epccs/Irrigate7/Uart/README.md

# AVR  Interrupt-Driven UART with stdio redirect

## Overview

Uart is an interactive command line program that demonstrates stdio redirect of a minimalized interrupt-driven UART core. 

Referance ATmega1284p datasheet USART Universal Synchronous and Asynchronous serial Receiver and Transmitter.

## Firmware Upload

With a serial port connection (see BOOTLOAD_PORT in Makefile) and xboot installed on the Irrigate7 run 'make bootload' and it should compile and then flash the MCU.

```
sudo apt-get install git gcc-avr binutils-avr gdb-avr avr-libc avrdude
git clone https://github.com/epccs/Irrigate7/
cd /Irrigate7/Uart
make bootload
...
avrdude done.  Thank you.
``` 

Now connect with picocom (or ilk). Note I am often at another computer doing this through SSH. The Samba folder is for editing the files from Windows.

``` 
#exit is C-a, C-x
picocom -b 38400 /dev/ttyUSB0
``` 

# Commands

Commands are interactive over the serial interface at 38400 baud rate. The echo will start after the second character of a new line. 

## /0/id? [name|desc|avr-gcc]

identify 

``` 
/0/id?
{"id":{"name":"Uart","desc":"Irrigate7 (14320^5) Board /w atmega1284p","avr-gcc":"5.4.0"}}
```
