epccs/Irrigate7/AmpHr/README.md

# Amp-Hour Counter

## Overview

Use ADC reading to Accumulate at timed intervals from a sense resistor. This is an interactive command line program that demonstrates how the ATmega1284p can be used to track the discharge from a battery. 

[Adc]: ../Adc

# Firmware Upload

With a serial port connection (set the BOOTLOAD_PORT in Makefile) and xboot installed on the Irrigate7 run 'make bootload' and it should compile and then flash the MCU.

``` 
sudo apt-get install git gcc-avr binutils-avr gdb-avr avr-libc avrdude
git clone https://github.com/epccs/Irrigate7/
cd /Irrigate7/AmpHr
make bootload
...
avrdude done.  Thank you.
``` 

Now connect with picocom (or ilk). 

``` 
#exit is C-a, C-x
picocom -b 38400 /dev/ttyUSB0
``` 

or log the terminal session

``` 
script -f -c "picocom -b 38400 /dev/ttyUSB0" stuff.json
``` 

# Commands

Commands are interactive over the serial interface at 38400 baud rate. The echo will start after the second character of a new line. 

## /\[rpu_address\]/[command \[arg\]\]

rpu_address is taken from the I2C address 0x29 (e.g. get_Rpu_address() which is included form ../Uart/id.h). The value of rpu_address is used as a character in a string, which means don't use a null value (C strings are null terminated), but the ASCII value for '1' (0x31) is easy and looks nice, though I fear it will cause some confusion when it is discovered that the actual address value is 49.

Commands and their arguments follow.

## /0/id? \[name|desc|avr-gcc\]

identify 

``` 
/1/id?
{"id":{"name":"AmpHr","desc":"Irrigate7 (14320^5) Board /w atmega1284p","avr-gcc":"5.4.0"}}
```

##  /0/charge?

Report the discharge since the day-night state machine cleared the accumulation.

``` 
/1/charge?
{"CHRG_mAHr":"0.14","ACCUM_Sec":"27.40"}
/1/analog? 6,7
{"PWR_I":"0.017","PWR_V":"12.74"}
```

## [/0/analog? 0..7\[,0..7\[,0..7\[,0..7\[,0..7\]\]\]\]](../Adc#0analog-0707070707)

## [/0/pwm CH1..CH6,0..255](../Pwm#0pwm-ch1ch60255)

## [/0/pMod 14..16,INPUT|OUTPUT](../Digital#0pmod-1416inputoutput)

## [/0/dWrt 14..16,HIGH|LOW](../Digital#0dwrt-1416highlow)

## [/0/dTog 14..16](../Digital#0dtog-1416)

## [/0/dRe? 14..16](../Digital#0dre-1416)

## [/0/showstat ON|OFF](../Digital#0showstat-onoff)

## [/0/iscan?](../i2c-debug#0iscan)

## [/0/iaddr 0..127](../i2c-debug#0iaddr-0127)

## [/0/ibuff 0..255\[,0..255\[,0..255\[,0..255\[,0..255\]\]\]\]](../i2c-debug#0ibuff-02550255025502550255)

## [/0/ibuff?](../i2c-debug#0ibuff)

## [/0/iwrite](../i2c-debug#0iwrite)

## [/0/cs 0..3,ON|OFF](../CurrSour#0cs-01onoff)

## [/0/csp 0..0,ON|OFF](../CurrSour#0csp-00onoff)
