epccs/Irrigate7/Hardware/Design/14320BRD,BOM.csv

LINE | REF | QTY | EPCCS TYP | EPCCS PN | MFG@PN | DESCRIPTION | NOTES | COST EA | LINE COST | BIN
 |  |  |  |  |  | Irrigate7 Board |  |  | TOTAL
 |  |  |  |  |  | 9/2/18 (14320^5) |  |  | =SUM(J5:J100)
1 |  | =1/3 | BOARD | OSHPARK |  | PCB 2 LAYER ENIG 3 COPY | () | 56.70 | =C5*I5 | IRRIGATE7
 |  |  |  |  |  | NOTES
