epccs/Irrigate7/Hardware/Design/14320DIN,BOM.csv

LINE | REF | QTY | EPCCS TYP | EPCCS PN | MFG@PN | DESCRIPTION | NOTES | COST EA | LINE COST | BIN
 |  |  |  |  |  | Irrigate7 DIN |  |  | TOTAL
 |  |  |  |  |  | 9/2/18 (14320^5) |  |  | =SUM(J5:J100)
1 | HW1 HW2 | 2 | HW-DINMNT | USA10-4.6 | PHXCONT@1201578 | DINRAIL ADAPTER UNIVERSAL 10MM 2.75MM | (1) | 1.13 | =C5*I5 | SHLD
2 |  | 4 | HW-SCREW | ZN6PSMS38 | B&F@PSMS 006 0038 PH | PAN SHT MTL SCREW #6 PHP .38L ZN | (1) | 0.1022 | =C6*I6 | SHLD
 |  |  |  |  |  | NOTES
 |  |  |  |  |  | (1) Alternate part with same or better rating allowed
