epccs/Irrigate7/Hardware/Evaluation/readme.md

# Description

This shows the setup and method used for evaluation of Irrigate7.

# Table of References

# Table Of Contents:

0. ^5 Replace RPUno^9 in Garden
0. ^5 Port Software from RPUno^9
0. ^3 CL8 Interface
0. ^2 Crystal Check
0. ^2 RS422 Shield
0. ^2 Lifting DIN Mount
0. ^1 Sensor Loop Select
0. ^1 CCtest
0. ^1 With RPUftdi^2
0. ^0A LT3652 Timer

## ^5 Replace RPUno^9 in Garden

The old setup had a K3 board and an RPUno.

RPUno^9+3Valves RPUno^9 and 3 Valves

Replaced with Irrigate7 which has four unused drivers in this setup. K1 moved to K7, K2 moved to K6, and K3 moved to K5.

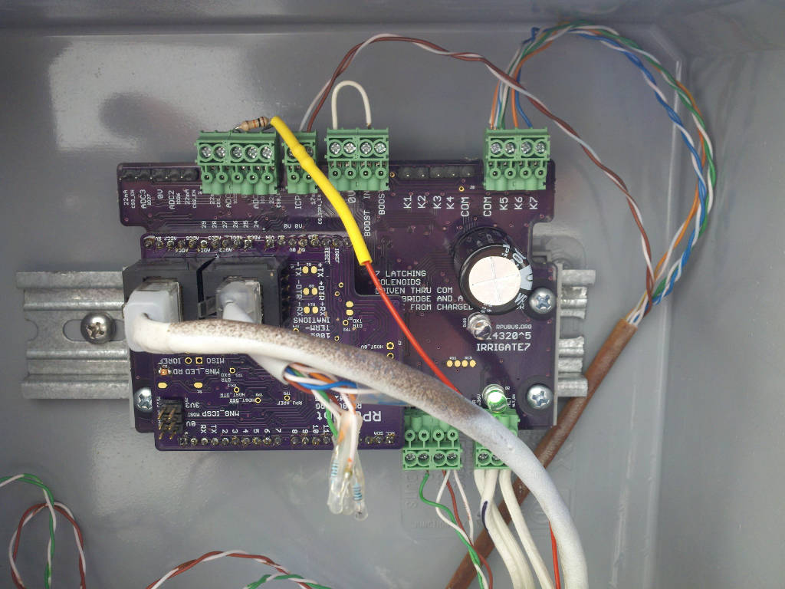
[picture p25: Hardware/Evaluation/Irrigate7^5+RPUadpt^5_w3ValvesPvBat.jpg]
Irrigate7^5 RPUadpt^5 and Valves


The valves have been operated for about two years with previous versions of K3 and RPUno, they were set and reset ten times each day so that is over 3500 operations each. The coil resistance is about 4.7 Ohm and they are driven through a CAT5 pair that is less than 4 meters (e.g. 0.19*4 Ohm). They are operating with a pulse voltage of 24VDC from a 2200uF capacitor, so the peak current has been near 3.75A, that is higher than I would like but has been working.

The [Irrigate7^5_log] will be updated as testing continues.

[Irrigate7^5_log]: Irrigate7^5_log.txt

## ^5 Port Software from RPUno^9

On Irrigate7^5 the LT3652, CL8 interface, ICP3, and Sensor Loop's were removed. Basically, it is now an RPUno with an extended K3 (to K7) on board. When swapping an RPUno^9+K3 for the Irrigate7^5  the wiring is a lot easier, but a few changes are present. The KNL software now fits (uses about 27%) with every command available, so I have room to extend. The ported software needs more testing but there is less that can go wrong now that much of the design is the same. 

SPI pins are now dedicated to that bus, ICP3 was on the MOSI pin. The RPUadpt^6 and hopefully the RPUpi^4 should allow options like SD cards and an SBC to do DAQ at higher rates. 

I am looking at doing an I2C board with a PCA6985 used to control 16 channels of 22mA current sources. They could be used to drive capacitive sensors (and a range of other things). I think they could feed one at a time into the ICP1 input when its current source is disabled to capture the capacitive sensor oscillator timing. This would need to be initiated by the SBC since it will need to figure out what to do with the data anyway.

## ^3 CL8 Interface

The IDE connector just fits, though there is interference with the shield. I can make the board larger but that will cost more, I think this will do.

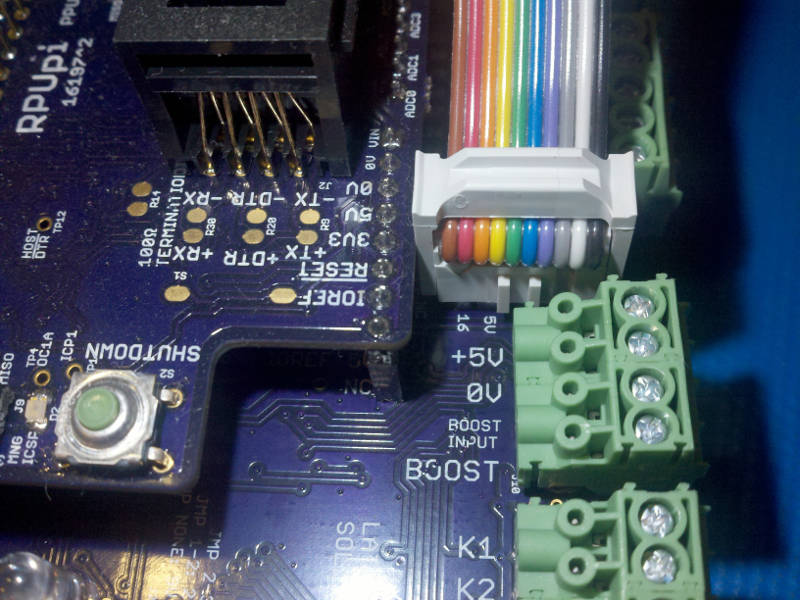
[picture p26: Hardware/Evaluation/Irrigat7^3,WithCL8Interface.jpg]
Irrigate7^3 CL8 Interface


## ^2 Crystal Check

The crystal has 27pF crystal capacitors which combine with the board's parasitic capacitance to make the crystals load capacitance.

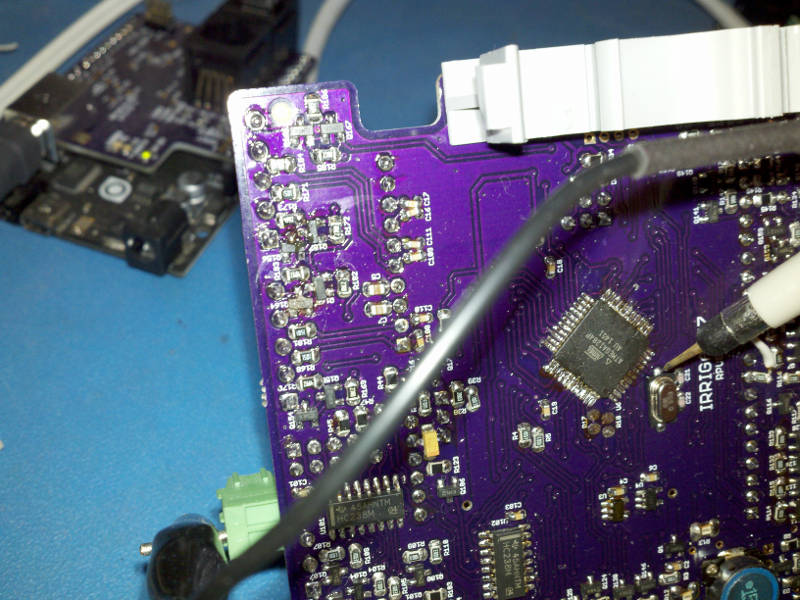
[picture p27: Hardware/Evaluation/Irrigat7^2,CrystalCheck.jpg]
Irrigate7^2 Crystal Check

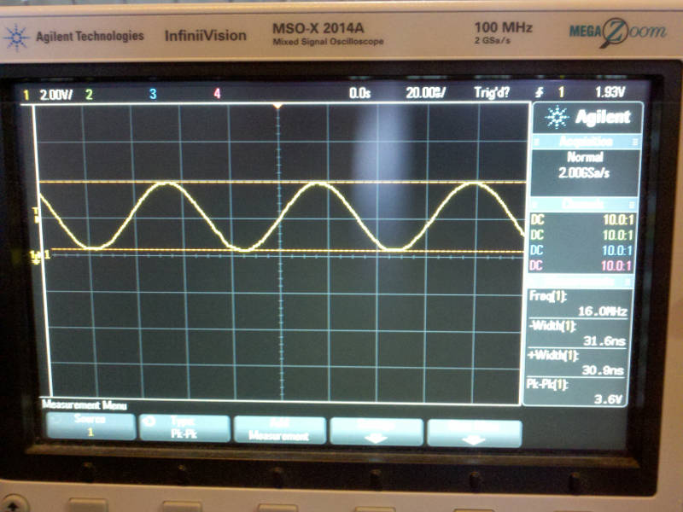
[picture p28: Hardware/Evaluation/Irrigat7^2,CrystalCheckOnDSO.jpg]
Irrigate7^2 Crystal Check On DSO


Previous versions had a different crystal that needed less capacitance (which unfortunately got copied onto other boards).

## ^2 RS422 Shield

RPUpi and RPUadpt are RS422 shields that connect to controller boards serial (RX/TX) lines. The RPUpi crosses over the host computer (Pi Zero) serial lines to the RS422. As a result, the host can talk to both the ATmega1284p on Irrigate7 and the ATmega328p on RPUno through the multidrop interface. The microcontrollers are programmed with the GNU GCC toolchain for AVR which is available on Raspiban (an OS that runs on the Pi Zero). The toolchain can build firmware (projects) for both the RPUno and Irrigate7. 

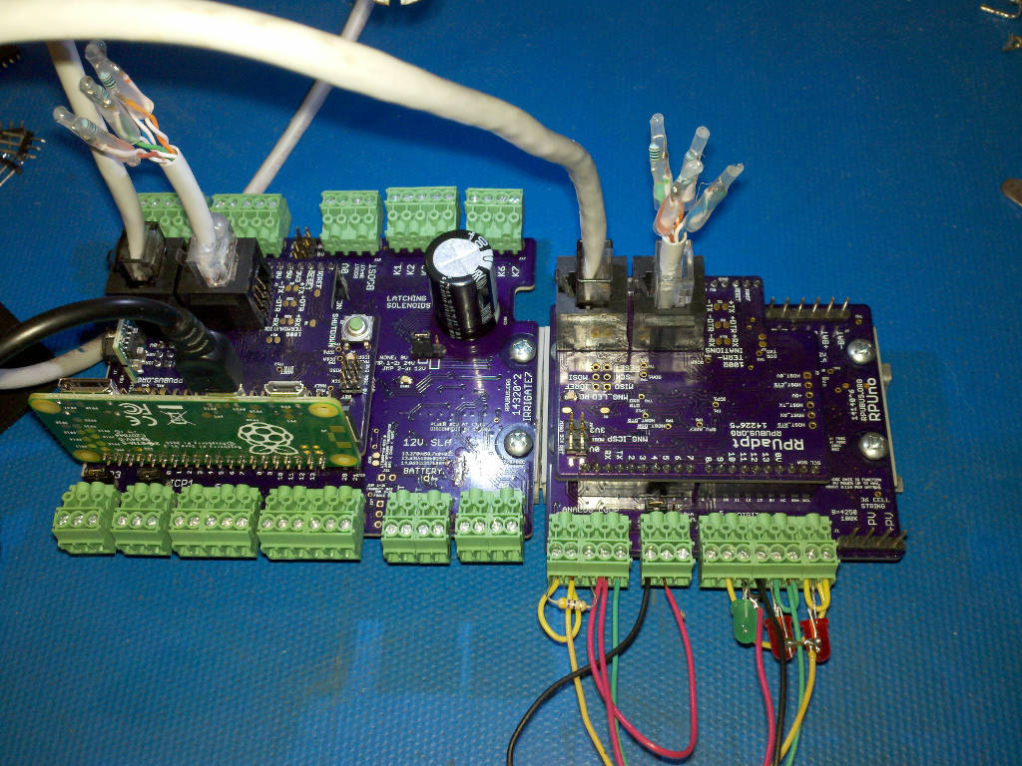
[picture p29: Hardware/Evaluation/Irrigat7^2,WithRPUpi^2_RS422to_RPUno^6_RPUadpt^5.jpg]
Irrigate7^2 RS422


## ^2 Lifting DIN Mount

A flat blade screwdriver is used to lift the DIN mount away from the rail, which is how almost all DIN systems work (though sometimes it is not this obvious).

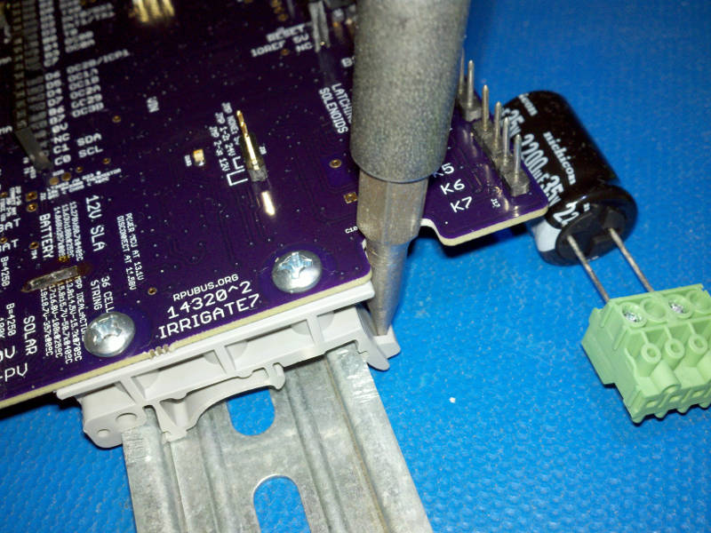
[picture p30: Hardware/Evaluation/14320^2,LiftingDinMount.jpg]
Irrigate7^2 Lift DIN Mount


## ^1 Sensor Loop Select

Using an [HT]^1 and [LoopPwr] firmware. The image shows a connection of the HT on LS2 and an LED on LS0. LS2 has ben selected and enabled with the firmware, and ICP1 is receving an inverted timing pulse from the sensor. See the [HT] for more info on the pulse sensor itself.

[HT]: https://github.com/epccs/LoopSensor/tree/master/HT
[LoopPwr]: ../../LoopPwr

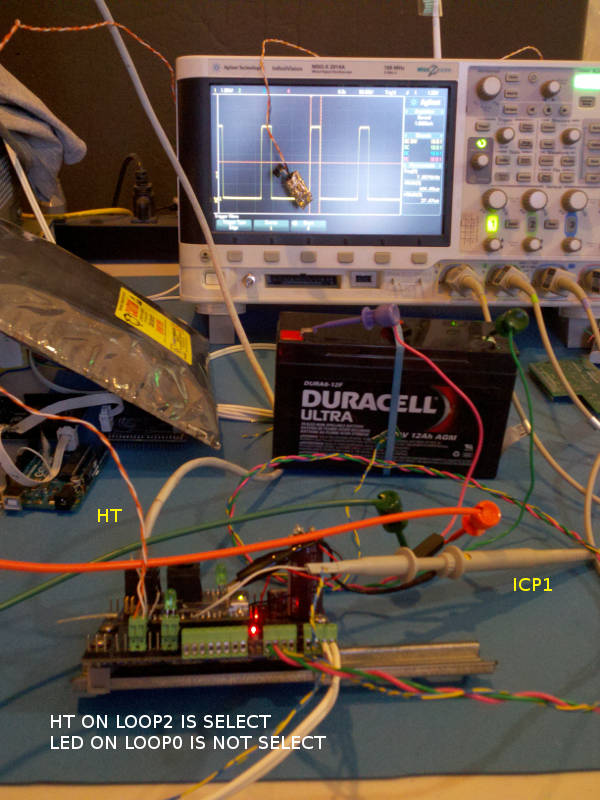
[picture p31: Hardware/Evaluation/14320^1,LoopSensorCheck.jpg]
Irrigate7^1 Loop Sensor


Note the Loop Sensor Select circuits have been done on the [CL8] board and will be removed from Irrigate7. This will allow both ICP1 and ICP3 to connect with pulse sensors of all sorts, e.g. two flow sensors, or a flow sensor on ICP3 and a calibration volume with a start and stop signal on ICP1. Since both ICP1 and ICP3 are driven by the same crystal there is no error caused by the use of multiple clock sources. I was once confused by a string of technical words that went something like "double precision chronometry" which used two time sources, and that is actually less accurate than the use of a single time source (it was also not a floating point, counts are integers, I think it just plays well in the ears). I've also verified that the AVR clock domains between the IO and CPU are fully synchronized (and deterministic), which means that the capture is truly accurate to within one crystal count. Any system on chip (SOC) running over about 50MHz has to have a separate clock domain for its IO and that means the capture can occur with more randomness than one count. I am doubtful if consecutive captures with those high-speed SOC can be used to build up a larger capture count for increased resolution. 

## ^1 CCtest

Using a testboard and [CCtest] firmware. LD0 was connected to DIO 10, LD1 to DIO 11, LD2 to DIO 12, LD3 to DIO 13. Analog channel 2 was connected to measure PV_I (the solar current), channel 3 measures the charging current, and channel 4 measures the battery discharge current.

[CCtest]: ../../CCtest

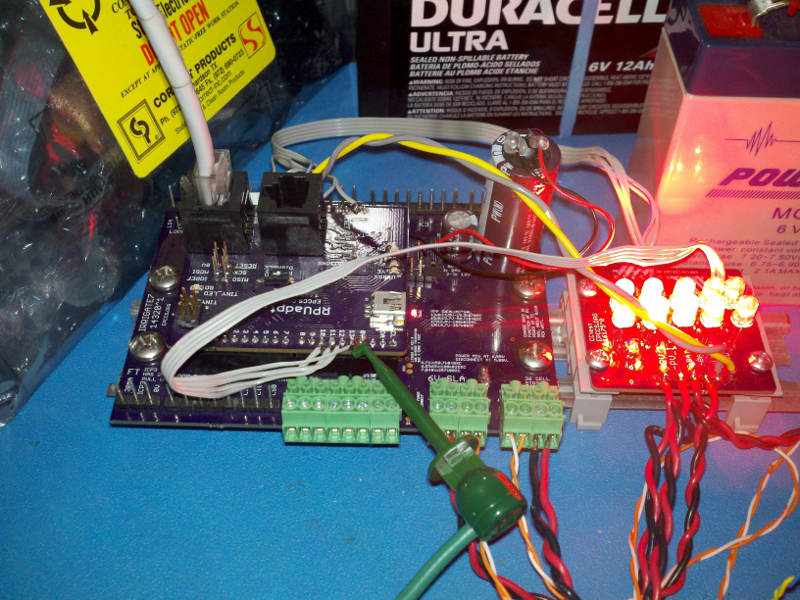
[picture p32: Hardware/Evaluation/14320^1,RPUadpt^2ShieldUsedToInterfaceCCtest^0.jpg]
Irrigate7^1 RPUadpt^2 CCtest^0


```
# time to remove surface charge down to 6.45V
surface_milli_sec = 480302-406141
# 74161

# time to remove charge down to 6.40V
shallow_milli_sec = 722406 - 577157
# 145249 // dropping .05V has taken 71 Sec longer

# time to remove charge down to 6.35V
bulk_milli_sec = 3087073 - 890142
# 2196931 // dropping .1V has taken 2122.7 Sec longer

# I think the bulk rate of discharge holds true to about 6V 
# thus the battery was run at the discharge rate (Amps)
discharge_amp = .146
# for the time it takes to go from shallow (6.4V) to bulk (6.35V)
bulk_hr = (bulk_milli_sec - shallow_milli_sec)/(1000*3600)
bulk_tested = 0.05
bulk_range = 6.4 -6.0
bulk_multiplier= bulk_range/bulk_tested

# how much bulk seems available
AHr = bulk_hr*bulk_multiplier*discharge_amp
# .67 AHr // but the battery is rated for 7AHr, clearly somthing is wrong.
```

## ^1 With RPUftdi^2
 
This version places the 2200uF reservoir capacitor for driving the latching solenoid in a notch of the RPUftdi board. 

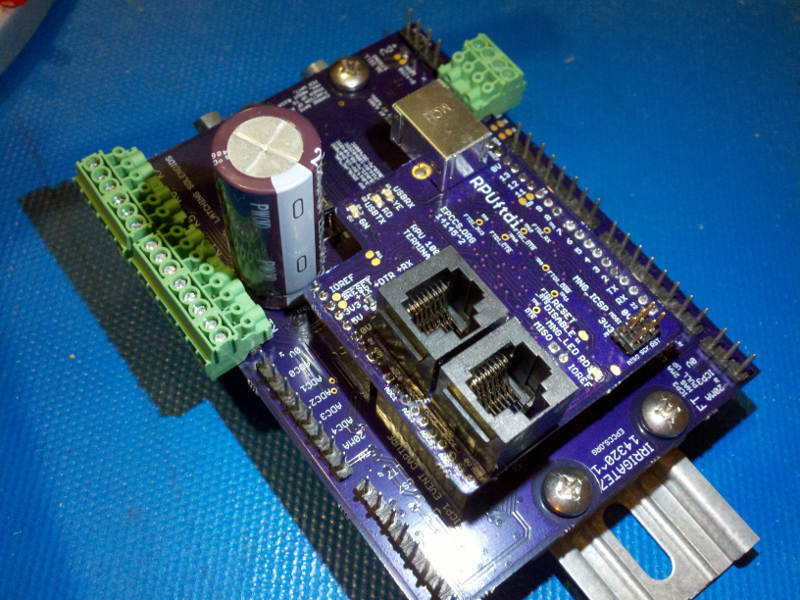
[picture p33: Hardware/Evaluation/14320^1,WithRPUftdi^2.jpg]
Irrigate7^1 With RPUftdi^2


## ^0A LT3652 Timer

This was the first circuit where correct operation of the LT3652 timer was seen.
    
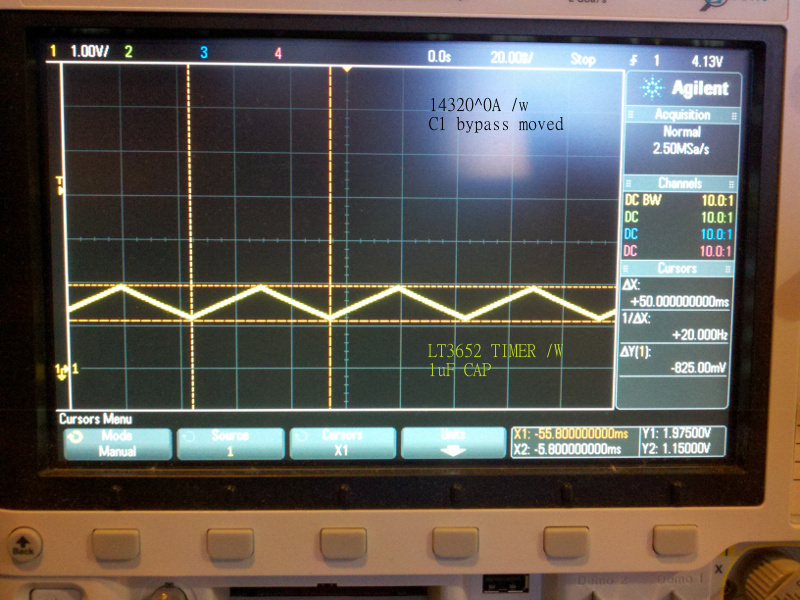
[picture p34: Hardware/Evaluation/14320^0A,LT3652timerSignal.jpg]
Irrigate7 With LT3652 Timer Working

    
The LT3652 timer drivers an internal counter that is used to set the float charge time (so it counts when the battery voltage control loop is active). Once the float charge is done it turns off until the voltage drops enough to start charging again. I think the idea is to give the SLA a little rest time.
