epccs/Irrigate7/Hardware/Documents/14320,Schematic.pdf

## POWER 7-36V

## BLOCKS -40V

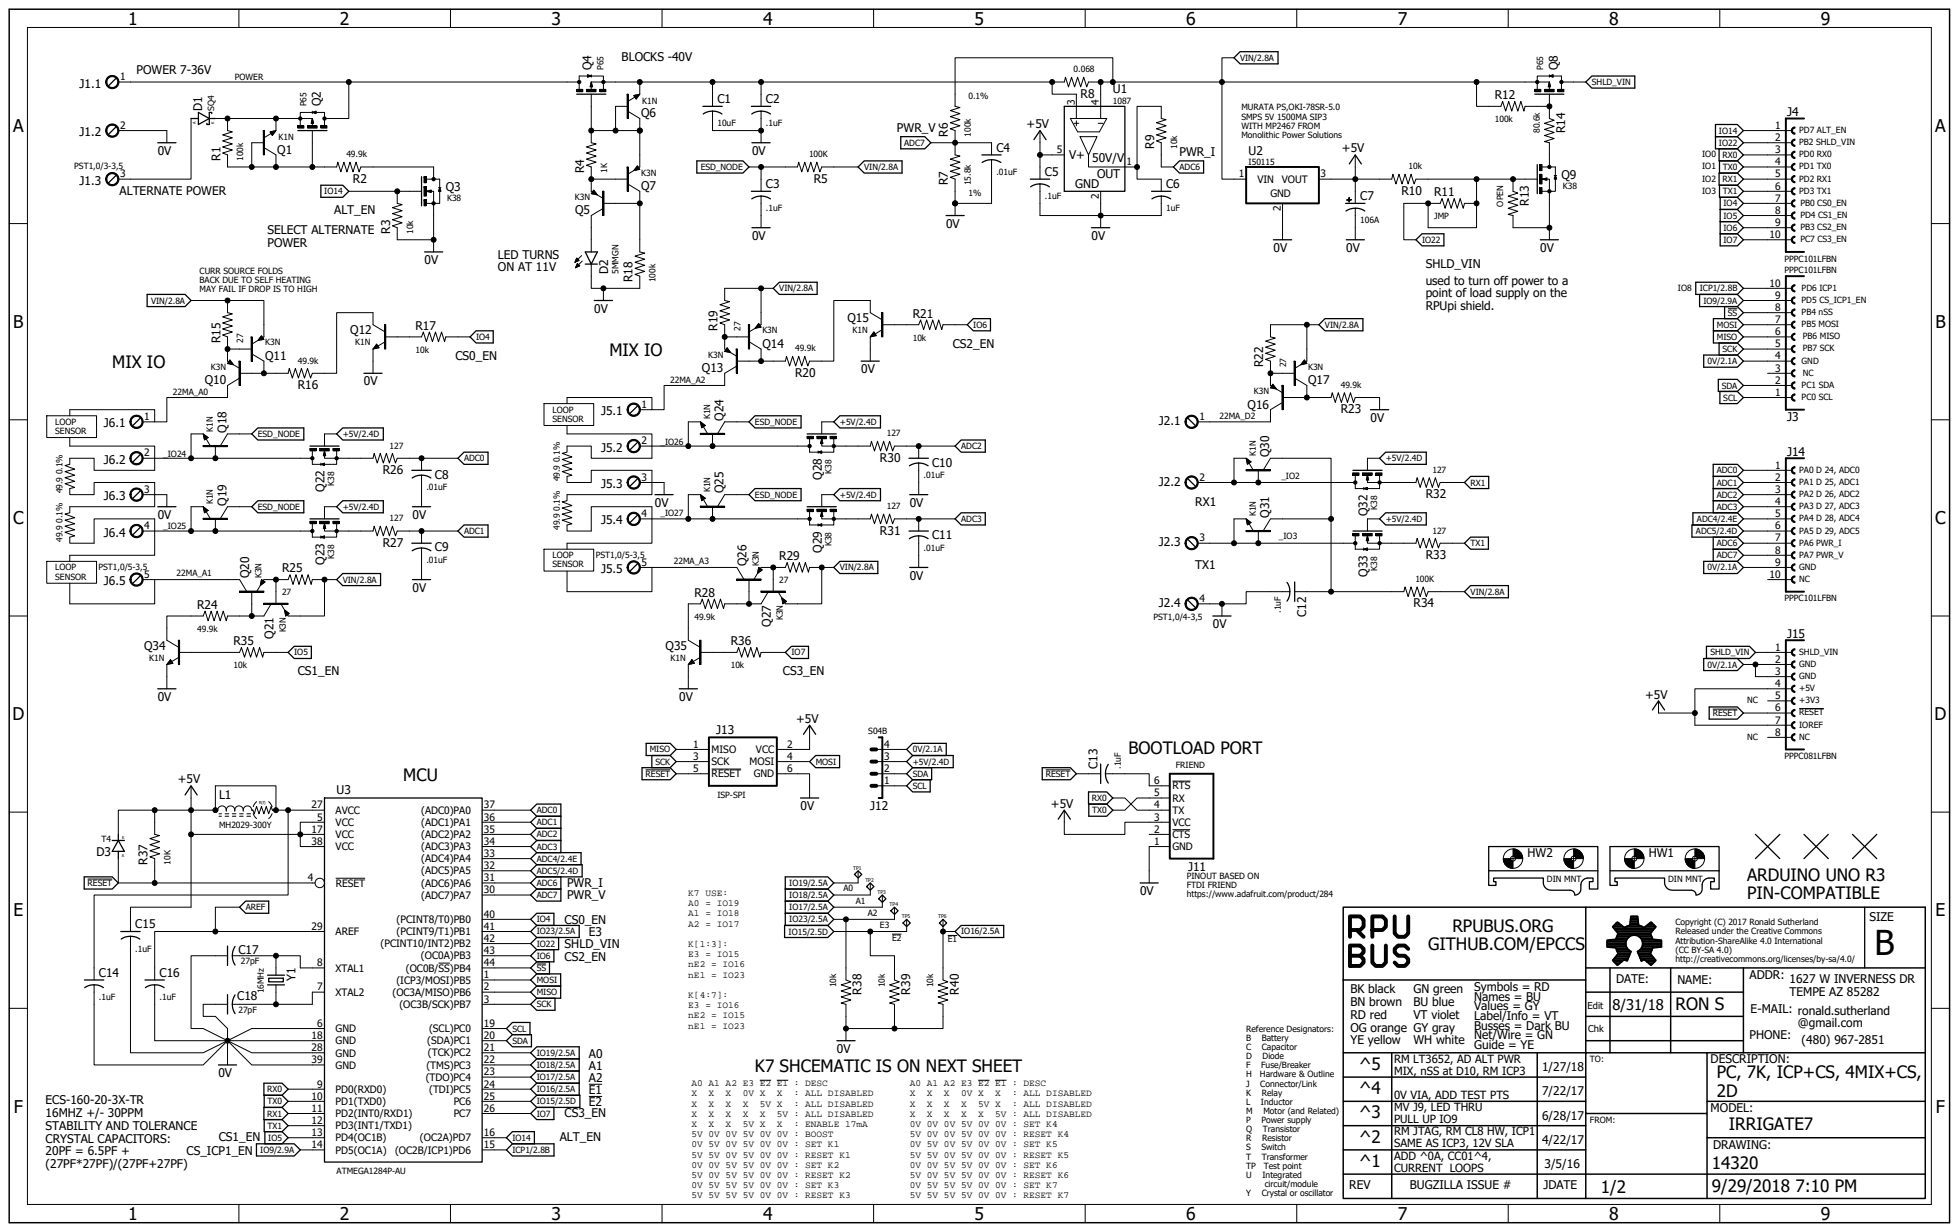
[picture p35: page 1]

SHLD_VIN
IO8 used to turn off power to a point of load supply on the
RPUpi shield.

CURR SOURCE FOLDS
BACK DUE TO SELF HEATING
MAY FAIL IF DROP IS TO HIGH

Copyright (C) 2017 Ronald Sutherland
Released under the Creative Commons
Attribution-ShareAlike 4.0 International
http://creativecommons.org/licenses/by-sa/4.0/

Edit | 8/31/18 | RON S

Chk

K7 SHCEMATIC IS ON NEXT SHEET

^5 | RM LT3652, AD ALT PWR MIX, nSS at D10, RM ICP3 | 1/27/18 | TO: | DESCRIPTION: PC, 7K, ICP+CS, 4MIX+CS, 2D
^4 | 0V VIA, ADD TEST PTS | 7/22/17
^3 | MV J9, LED THRU PULL UP IO9 | 6/28/17 | | MODEL: IRRIGATE7
^2 | RM JTAG, RM CL8 HW, ICP1 SAME AS ICP3, 12V SLA | 4/22/17
^1 | ADD ^0A, CC01^4, CURRENT LOOPS | 3/5/16

REV | BUGZILLA ISSUE # | JDATE

K1

## WITH COMMON HALF BRIDGE

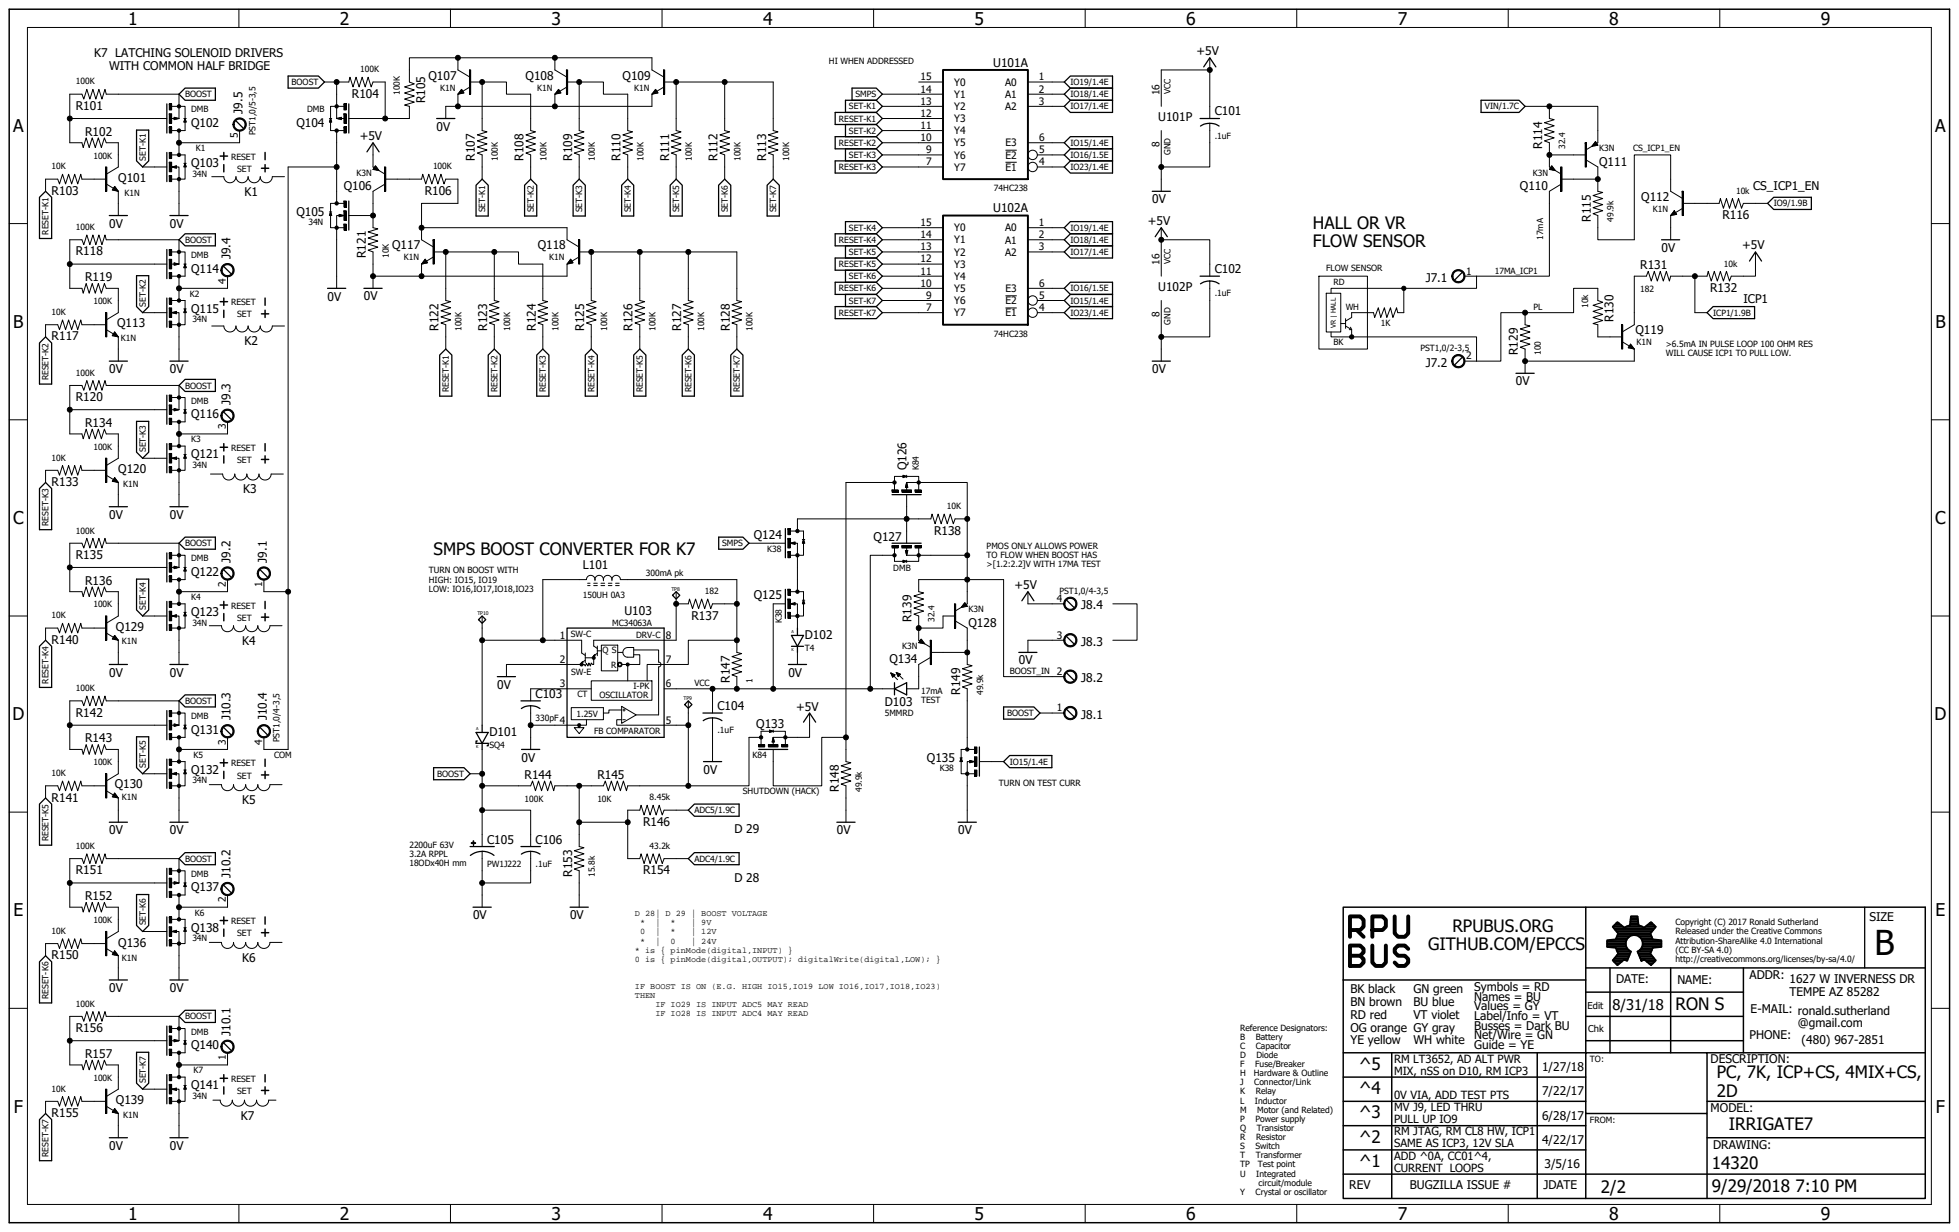
[picture p36: page 2]

K7 LATCHING SOLENOID DRIVERS

>6.5mA IN PULSE LOOP 100 OHM RES
WILL CAUSE ICP1 TO PULL LOW.

SMPS BOOST CONVERTER FOR K7

PMOS ONLY ALLOWS POWER
TO FLOW WHEN BOOST HAS
>[1.2:2.2]V WITH 17MA TEST

TURN ON BOOST WITH
HIGH: IO15, IO19
LOW: IO16,IO17,IO18,IO23

TURN ON TEST CURR

D 28| D 29 | BOOST VOLTAGE
* is { pinMode(digital,INPUT) }
0 is { pinMode(digital,OUTPUT); digitalWrite(digital,LOW); }

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

IF BOOST IS ON (E.G. HIGH IO15,IO19 LOW IO16,IO17,IO18,IO23)
THEN
IF IO29 IS INPUT ADC5 MAY READ
IF IO28 IS INPUT ADC4 MAY READ

Edit | 8/31/18 | RON S

Chk

^5 | RM LT3652, AD ALT PWR MIX, nSS on D10, RM ICP3 | 1/27/18 | TO: | DESCRIPTION: PC, 7K, ICP+CS, 4MIX+CS, 2D
^4 | 0V VIA, ADD TEST PTS | 7/22/17
^3 | MV J9, LED THRU PULL UP IO9 | 6/28/17 | | MODEL: IRRIGATE7
^2 | RM JTAG, RM CL8 HW, ICP1 SAME AS ICP3, 12V SLA | 4/22/17
^1 | ADD ^0A, CC01^4, CURRENT LOOPS | 3/5/16

REV | BUGZILLA ISSUE # | JDATE
