epccs/Irrigate7/Hardware/Documents/14320,bAssy.pdf

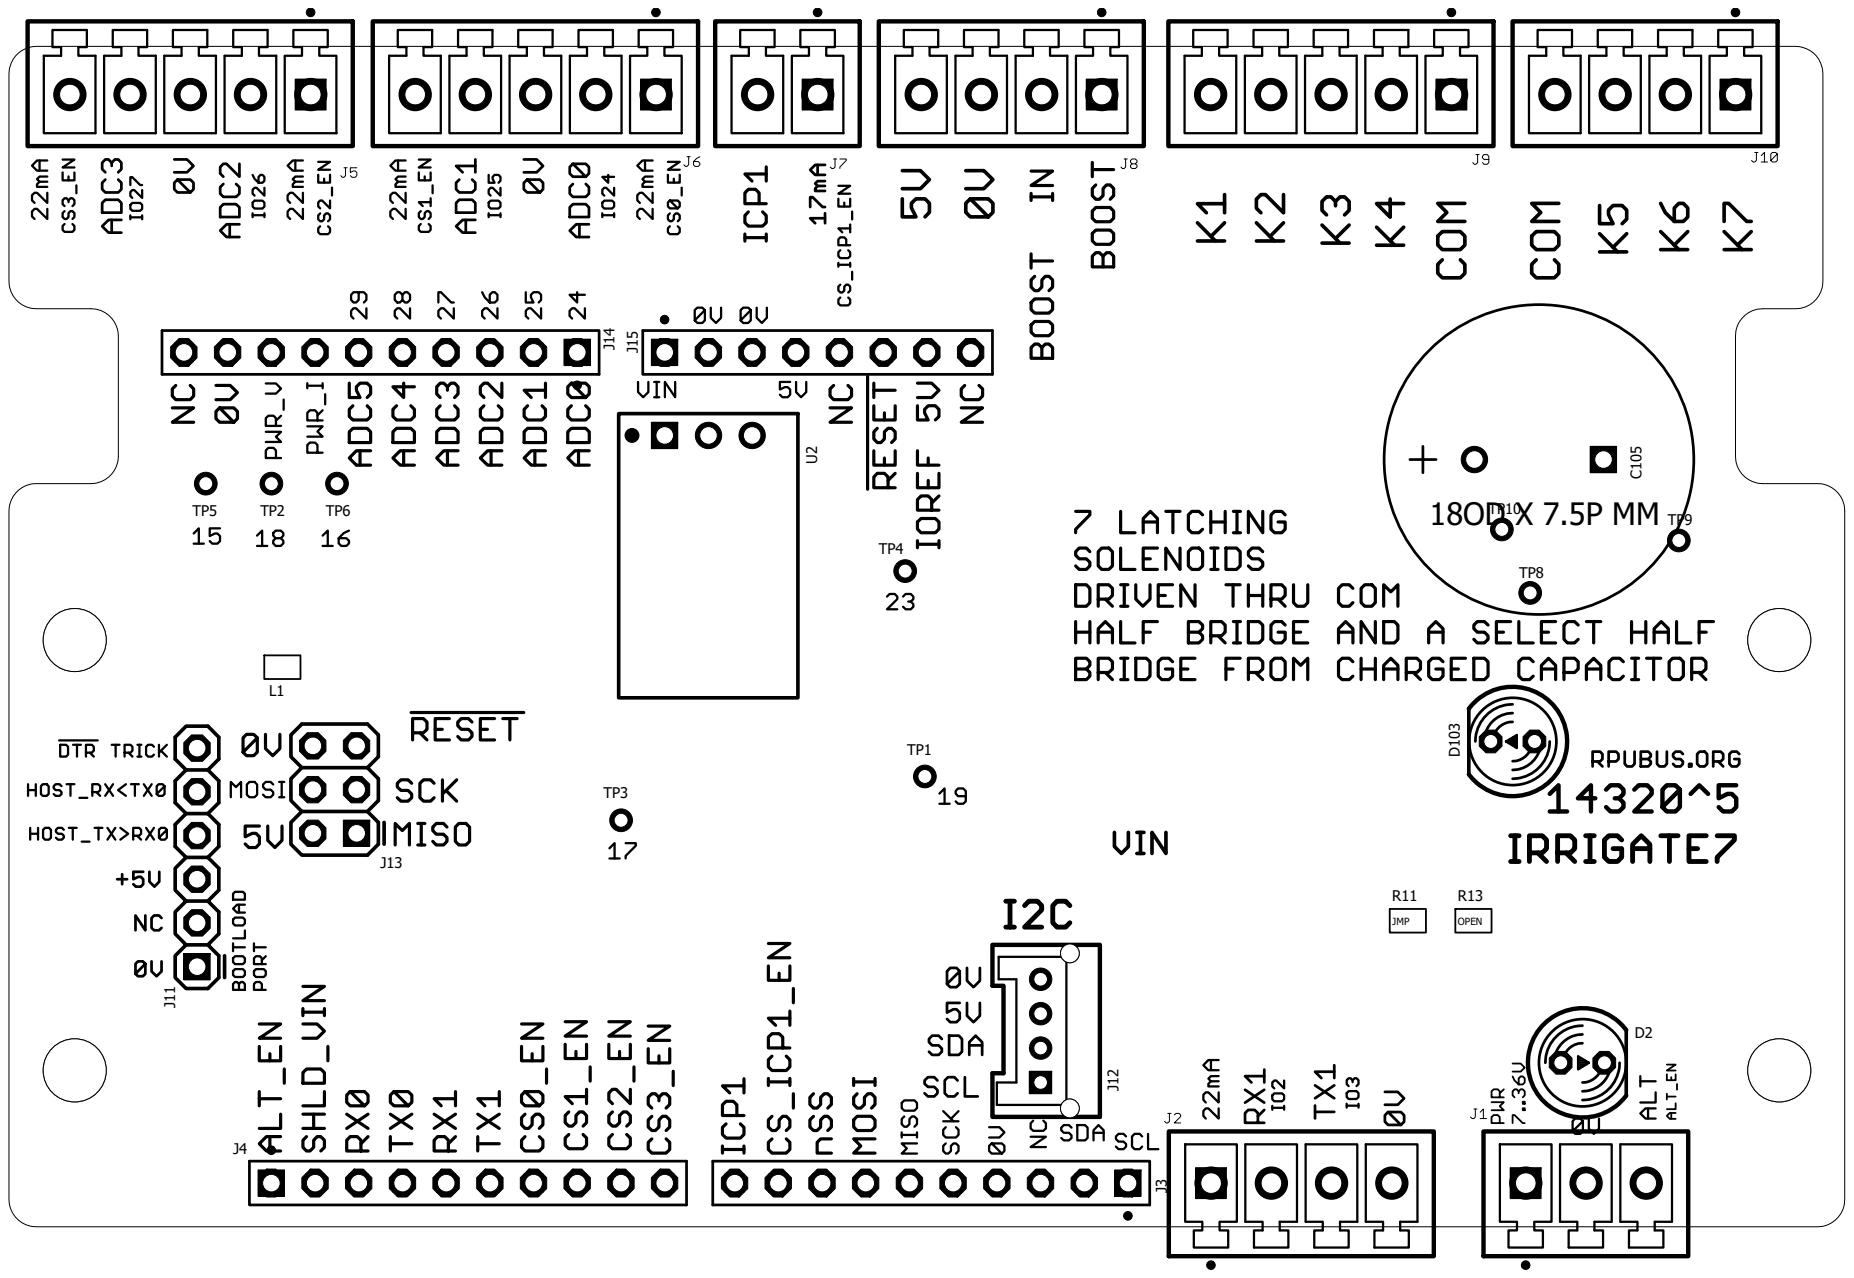
[picture p37: page 1]
