epccs/Irrigate7/Hardware/Documents/14320,tAssy.pdf

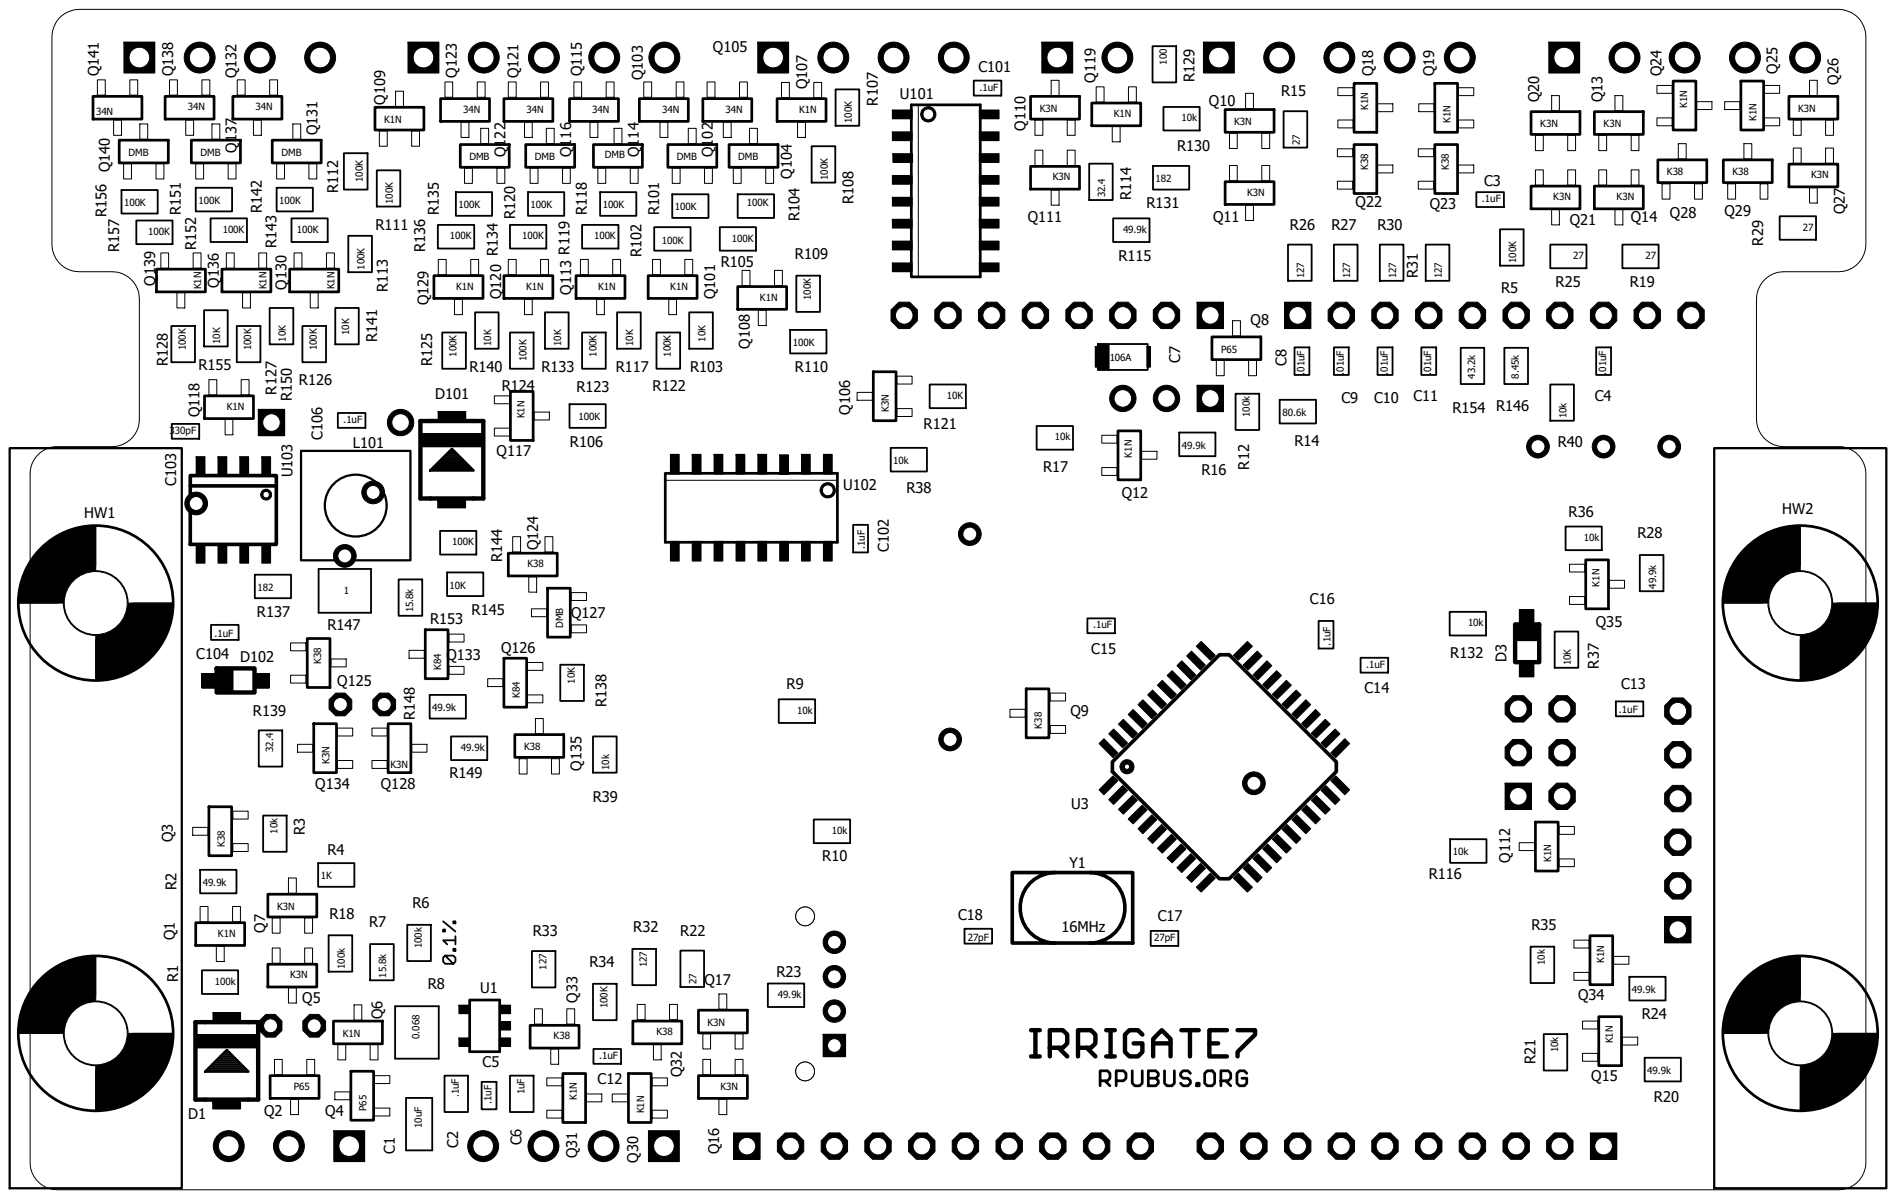
[picture p38: page 1]
