epccs/Irrigate7/Alternat/Setup/AuxilaryWiring.sch

## EAGLE design Alternat/Setup/AuxilaryWiring.sch (2018-12-16)

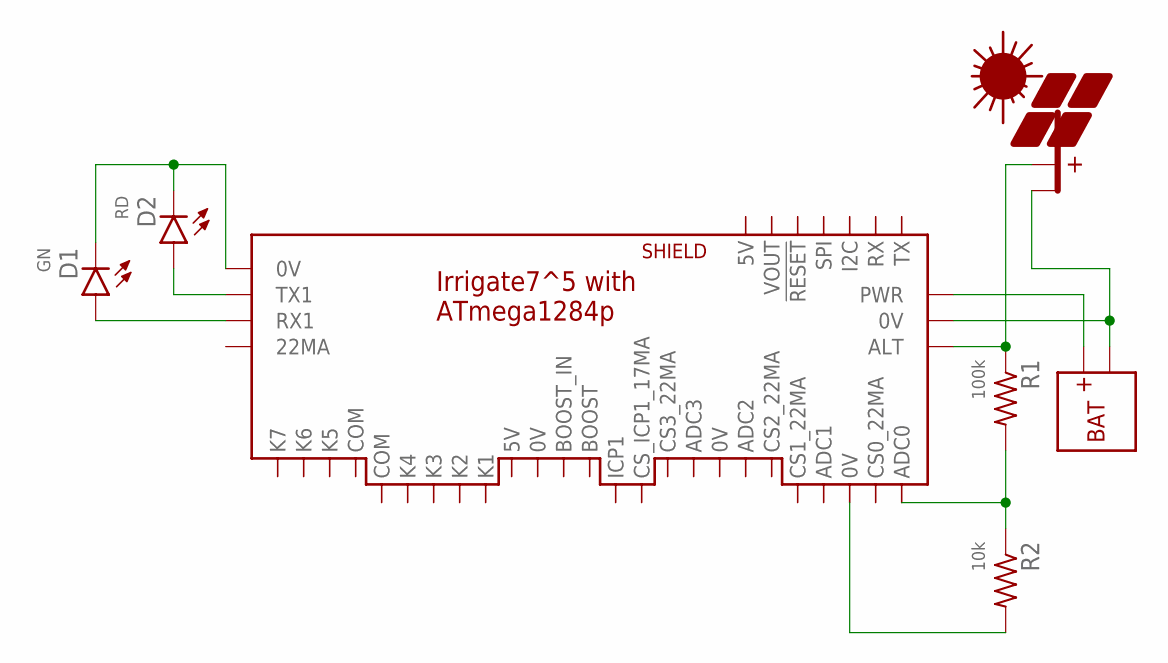
[picture p39: schematic AuxilaryWiring.sch]

Parts:
D1: GN; LED5MM
D2: RD; LED5MM
PV4: PV; NA-30
R1: 100k; C0805(2012)
R2: 10k; C0805(2012)
U$1: IRRIGATE7; WITH_RPU_NAMES
U$7: BAT; NA-30

Connections:
unnamed: D1.A, U$1.DIO2 (RX1)
unnamed: D1.K, D2.K, U$1.17MA@ICP3 (0V)
unnamed: D2.A, U$1.DIO3 (TX1)
unnamed: R1.2, R2.1, U$1.ADC0
unnamed: R2.2, U$1.0V@ADC2 (0V)
unnamed: U$1.PWR, U$7.1 (+BAT)
unnamed: PV4.2 (-PV), U$1.0V@PWR (0V), U$7.2 (-BAT)
unnamed: PV4.1 (+PV), R1.1, U$1.AUX (ALT)
