epccs/Irrigate7/DayNight/Setup/LightSensorWiring.sch

## EAGLE design DayNight/Setup/LightSensorWiring.sch (2018-12-11)

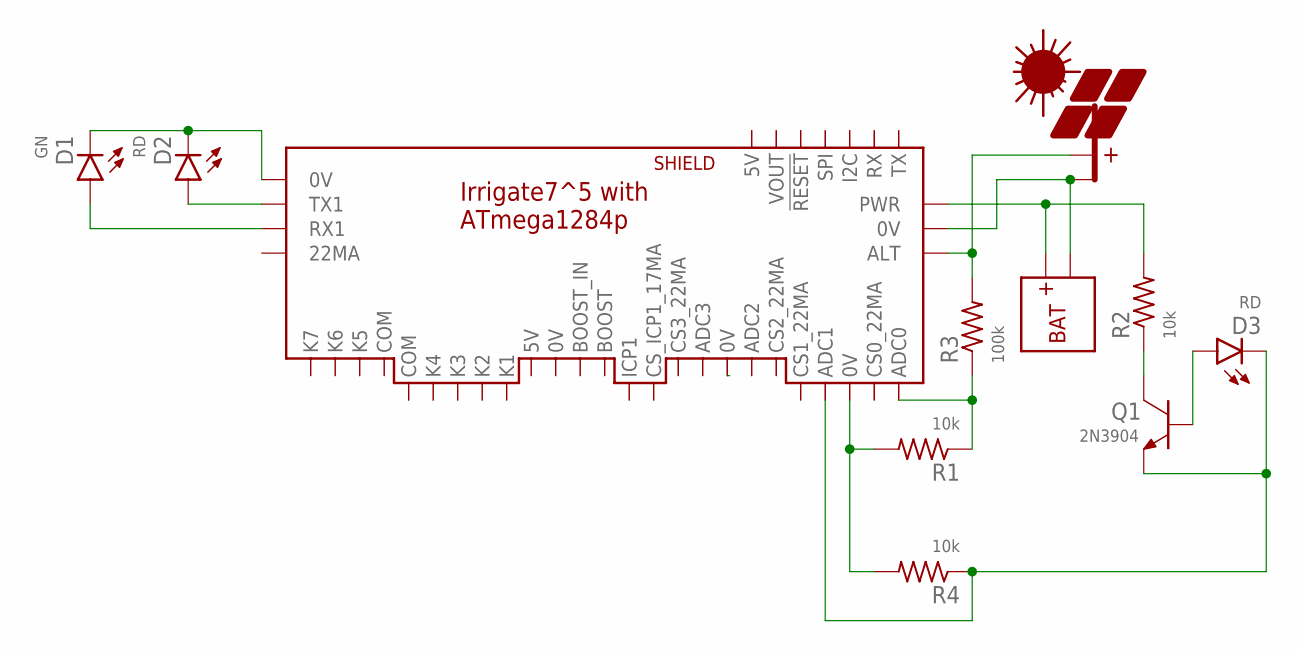
[picture p40: schematic LightSensorWiring.sch]

Parts:
D1: GN; LED5MM
D2, D3: RD; LED5MM
PV4: PV; NA-30
Q1: 2N3904; SOT23
R1, R2, R4: 10k; C0805(2012)
R3: 100k; C0805(2012)
U$1: IRRIGATE7; WITH_RPU_NAMES
U$7: BAT; NA-30

Connections:
0V: PV4.2 (-PV), U$1.0V@PWR (0V), U$7.2 (-BAT)
GN-WHT: U$1.ICP3 (0V)
unnamed: R2.2, U$1.PWR, U$7.1 (+BAT)
unnamed: R1.2, R4.2, U$1.0V@ADC2 (0V)
unnamed: D1.K, D2.K, U$1.17MA@ICP3 (0V)
unnamed: D3.A, Q1.B
unnamed: D3.K, Q1.E, R4.1, U$1.ADC1
unnamed: R1.1, R3.1, U$1.ADC0
unnamed: Q1.C, R2.1
unnamed: D2.A, U$1.DIO3 (TX1)
unnamed: D1.A, U$1.DIO2 (RX1)
unnamed: PV4.1 (+PV), R3.2, U$1.AUX (ALT)
