epccs/Irrigate7/Hardware/Design/MultiDrop.sch

## EAGLE design Hardware/Design/MultiDrop.sch (2018-11-09)

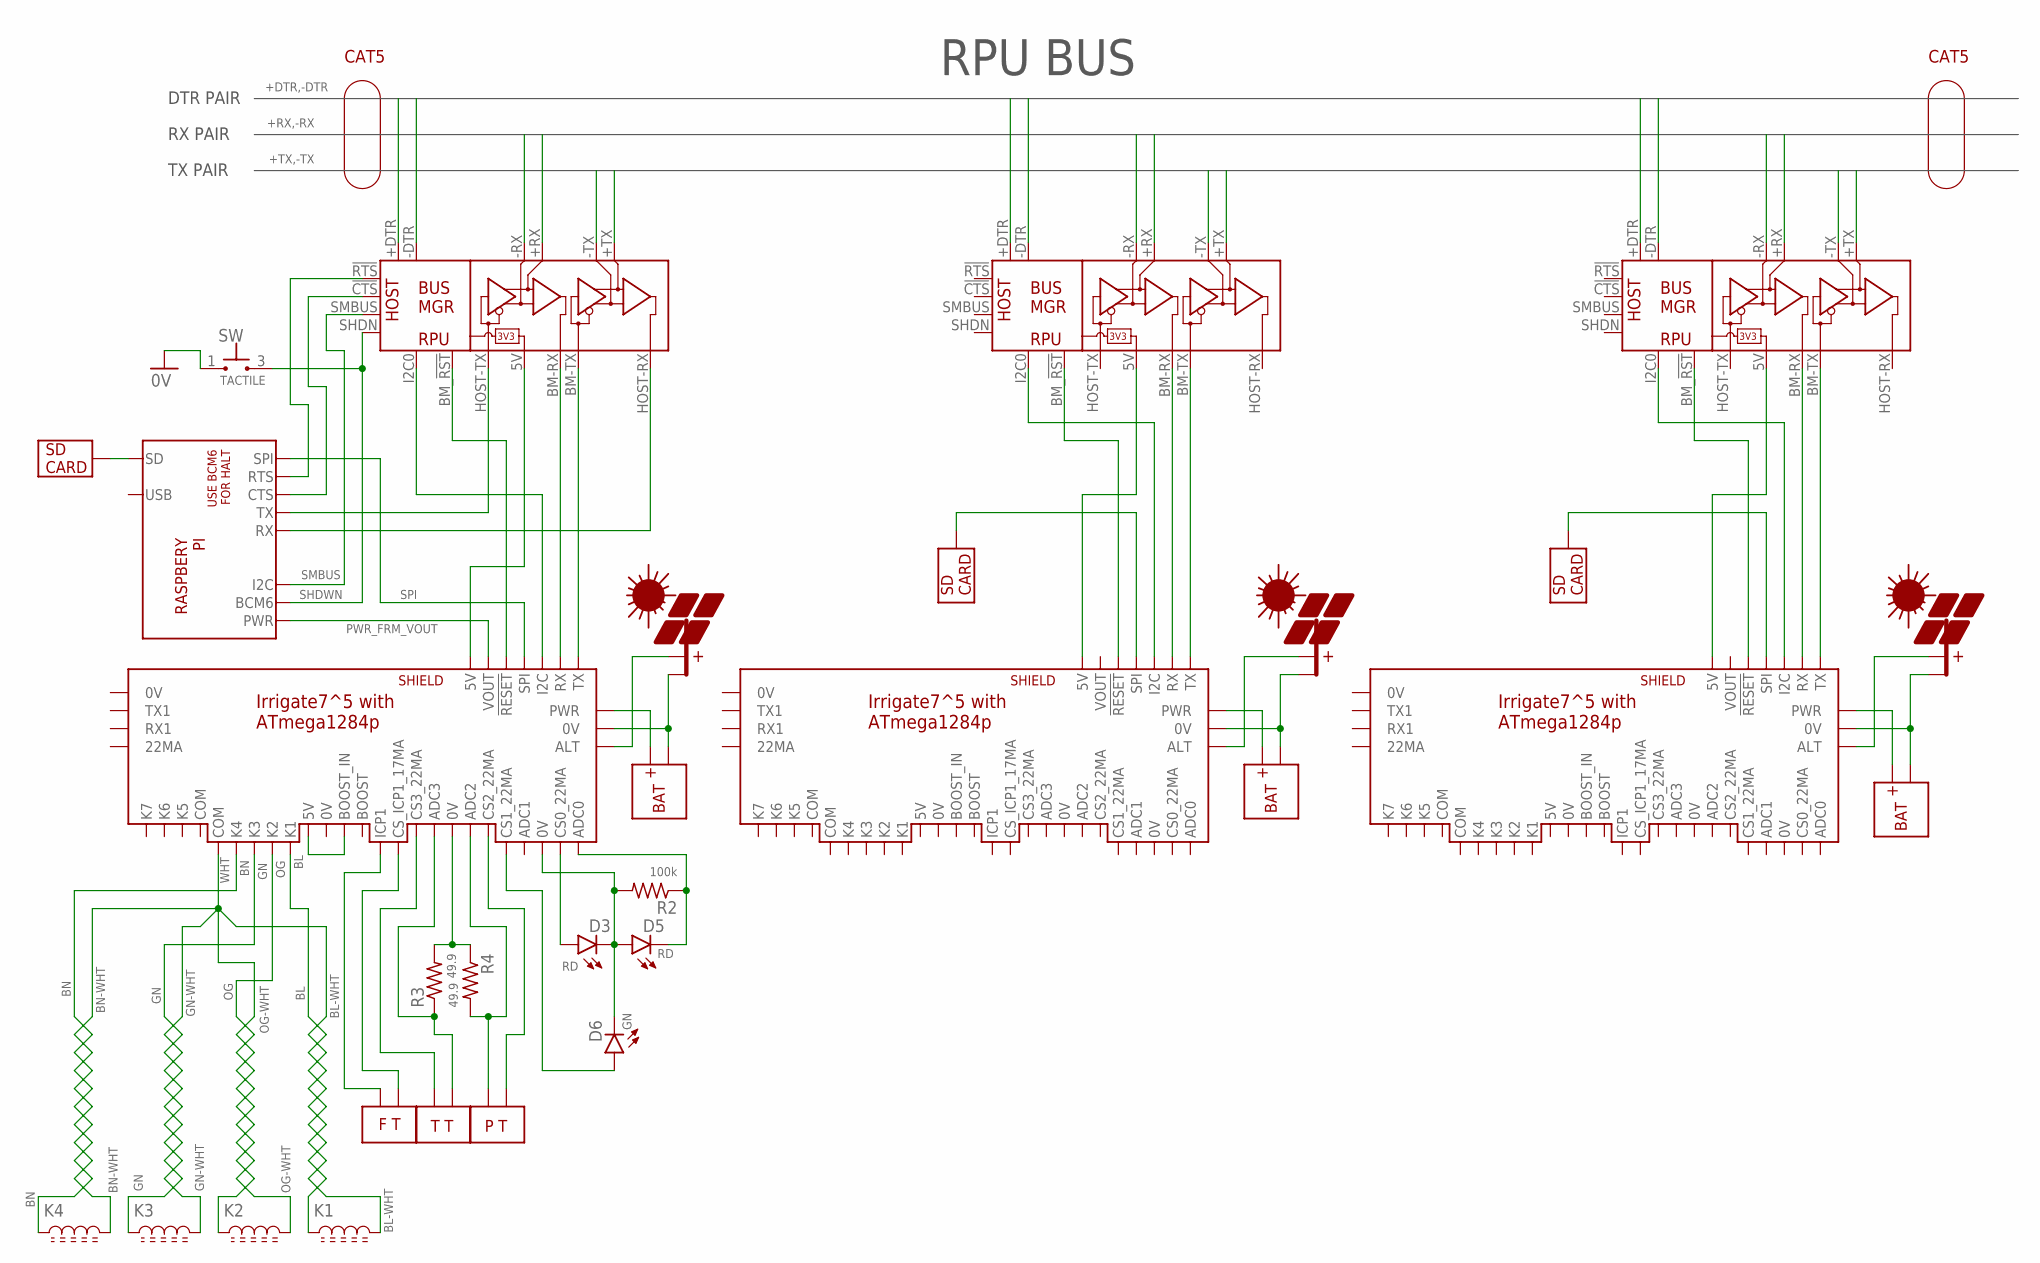
[picture p41: schematic MultiDrop.sch]

Parts:
D3, D5: RD; LED5MM
D6: GN; LED5MM
K1, K2, K3, K4: L0805; C0805(2012)
PV1, PV2, PV4: PV; NA-30
R2: 100k; C0805(2012)
R3, R4: 49.9; C0805(2012)
SD1, SD2, SD3: SD; NA-30
SW: TACTILE; KS11
U$1, U$8, U$12: BUS_MGR; WITH_RPU_NAMES
U$2, U$4, U$10: IRRIGATE7; WITH_RPU_NAMES
U$3, U$7, U$9: BAT; NA-30
U$5: FT; NA-30
U$6: TT; NA-30
U$11: PT; NA-30
U$13: PI; NA-30

Connections:
0V: SW.1
+DTR: U$1.+DTR
+DTR1: U$8.+DTR
+DTR3: U$12.+DTR
+RX: U$1.+RX
+RX1: U$8.+RX
+RX3: U$12.+RX
+TX: U$1.+TX
+TX1: U$8.+TX
+TX3: U$12.+TX
-DTR: U$1.-DTR
-DTR1: U$8.-DTR
-DTR3: U$12.-DTR
-RX: U$1.-RX
-RX1: U$8.-RX
-RX3: U$12.-RX
-TX: U$1.-TX
-TX1: U$8.-TX
-TX3: U$12.-TX
BL: K1.1, U$2.K1
BL-WHT: K1.2
BN: K4.1, U$2.K4
BN-WHT: K4.2
GN: K3.1, U$2.K3
GN-WHT: K3.2
unnamed: U$1.BM-TX (BM_TX), U$2.TX
unnamed: U$1.BM-RX (BM_RX), U$2.RX
unnamed: SD1.1, U$13.9 (SD)
unnamed: U$1.!CTS, U$13.1 (CTS)
unnamed: U$1.!RTS, U$13.2 (RTS)
unnamed: D3.K, D5.A, D6.K, R2.2, U$2.0V@ADC2 (0V)
unnamed: D3.A, U$2.22MA@ADC0 (CS0_22MA)
unnamed: U$1.HOST-RX (HOST_RX), U$13.3 (RX)
unnamed: U$1.HOST-TX (HOST_TX), U$13.4 (TX)
unnamed: U$4.TX, U$8.BM-TX (BM_TX)
unnamed: U$4.RX, U$8.BM-RX (BM_RX)
unnamed: PV2.2 (-PV), U$4.0V@PWR (0V), U$9.2 (-BAT)
unnamed: PV4.2 (-PV), U$7.2 (-BAT), U$10.0V@PWR (0V)
unnamed: U$10.TX, U$12.BM-TX (BM_TX)
unnamed: PV4.1 (+PV), U$10.AUX (ALT)
unnamed: U$7.1 (+BAT), U$10.PWR
unnamed: U$2.ICP1, U$5.2 (PWR)
unnamed: R3.2, R4.1, U$2.ICP3 (0V)
unnamed: U$2.17MA@ICP1 (CS_ICP1_17MA), U$5.1 (PL)
unnamed: R4.2, U$2.ADC4 (ADC2), U$11.2 (PWR)
unnamed: U$10.RX, U$12.BM-RX (BM_RX)
unnamed: PV2.1 (+PV), U$4.AUX (ALT)
unnamed: U$2.5V, U$2.BOOST_IN
unnamed: U$2.22MA@ADC5 (CS3_22MA), U$6.2 (PWR)
unnamed: R3.1, U$2.ADC5 (ADC3), U$6.1 (4TO20)
unnamed: D6.A, U$2.22MA@ADC1 (CS1_22MA)
unnamed: SD3.1, U$4.SPI
unnamed: SD2.1, U$10.SPI
unnamed: U$1.5V (PWR), U$2.SHLD_5V (5V)
unnamed: U$1.BM_!RST! (BM-!RST!), U$2.!RESET
unnamed: U$2.22MA@ADC4 (CS2_22MA), U$11.1 (4TO20)
unnamed: U$10.I2C, U$12.I2C0
unnamed: U$1.I2C0, U$2.I2C
unnamed: PV1.2 (-PV), U$2.0V@PWR (0V), U$3.2 (-BAT)
unnamed: D5.K, R2.1, U$2.ADC0
unnamed: U$10.SHLD_5V (5V), U$12.5V (PWR)
unnamed: U$4.PWR, U$9.1 (+BAT)
unnamed: U$10.!RESET, U$12.BM_!RST! (BM-!RST!)
unnamed: U$4.!RESET, U$8.BM_!RST! (BM-!RST!)
unnamed: U$4.I2C, U$8.I2C0
unnamed: U$2.PWR, U$3.1 (+BAT)
unnamed: PV1.1 (+PV), U$2.AUX (ALT)
OG: K2.1, U$2.K2
OG-WHT: K2.2
PWR_FRM_VOUT: U$2.SHLD_VOUT (VOUT), U$13.12 (PWR)
SHDWN: SW.3, U$1.SHDN, U$13.7 (BCM6)
SMBUS: U$1.SMBUS, U$13.8 (I2C)
SPI: U$2.SPI, U$13.10 (SPI)
WHT: U$2.COM@K4 (COM)

Notes on the sheet:
CAT5
DTR PAIR
RX PAIR
TX PAIR
RPU BUS
