epccs/Irrigate7/NightLight/Setup/NightLightWiring.sch

## EAGLE design NightLight/Setup/NightLightWiring.sch (2018-12-23)

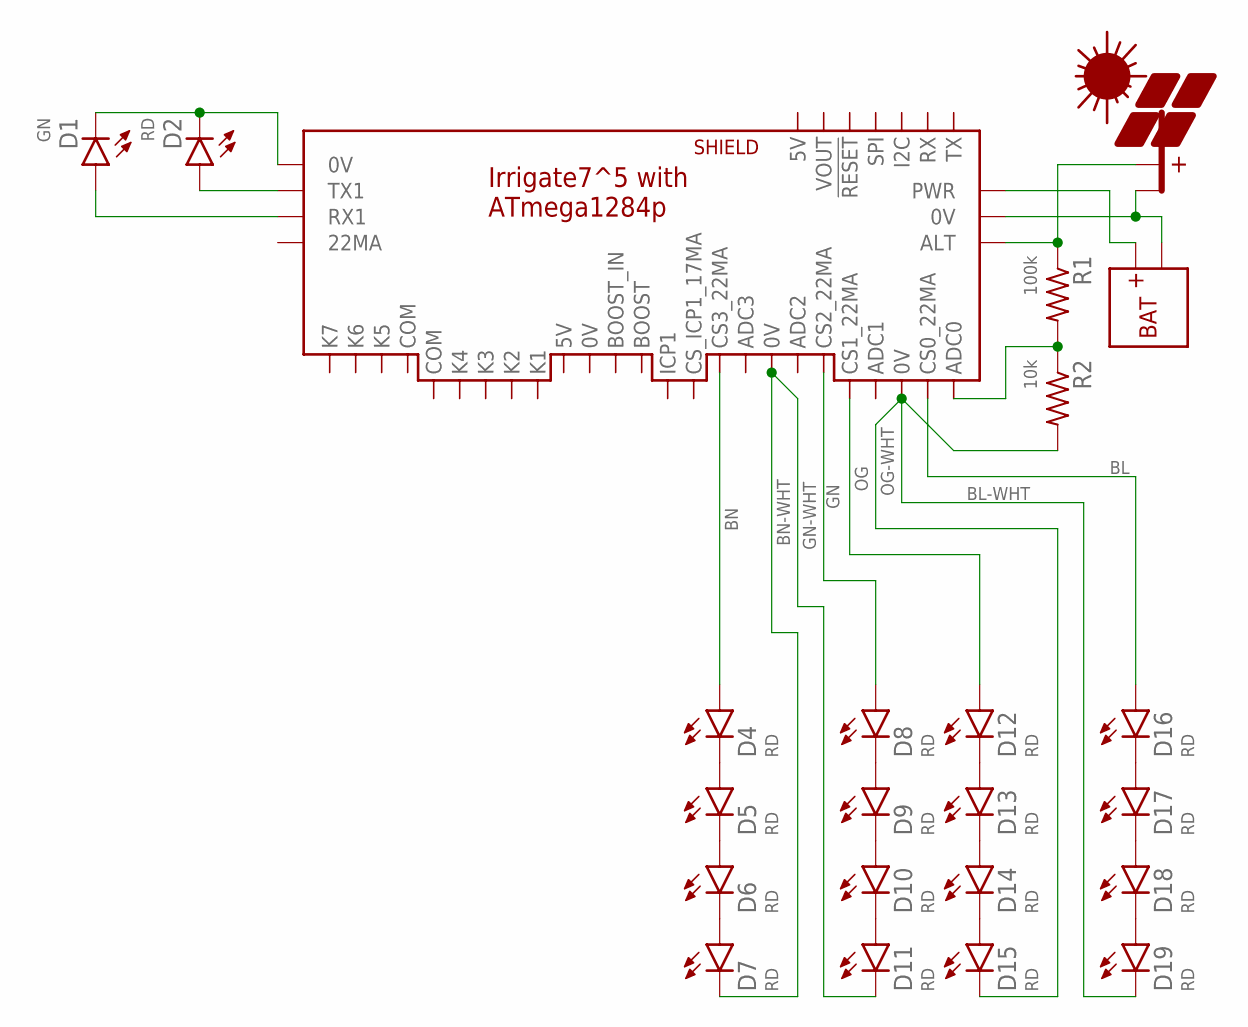
[picture p43: schematic NightLightWiring.sch]

Parts:
D1: GN; LED5MM
D2, D4, D5, D6, D7, D8, D9, D10, D11, D12, D13, D14, D15, D16, D17, D18, D19: RD; LED5MM
PV4: PV; NA-30
R1: 100k; C0805(2012)
R2: 10k; C0805(2012)
U$1: IRRIGATE7; WITH_RPU_NAMES
U$7: BAT; NA-30

Connections:
0V: PV4.2 (-PV), U$1.0V@PWR (0V), U$7.2 (-BAT)
BL: D16.A, U$1.22MA@ADC0 (CS0_22MA)
BL-WHT: D19.K
BN: D4.A, U$1.22MA@ADC5 (CS3_22MA)
BN-WHT: D7.K
GN: D8.A, U$1.22MA@ADC4 (CS2_22MA)
GN-WHT: D11.K, U$1.ICP3 (0V)
unnamed: U$1.PWR, U$7.1 (+BAT)
unnamed: D1.K, D2.K, U$1.17MA@ICP3 (0V)
unnamed: D4.K, D5.A
unnamed: D5.K, D6.A
unnamed: D6.K, D7.A
unnamed: D8.K, D9.A
unnamed: D9.K, D10.A
unnamed: D10.K, D11.A
unnamed: D13.K, D14.A
unnamed: D14.K, D15.A
unnamed: D16.K, D17.A
unnamed: D17.K, D18.A
unnamed: D18.K, D19.A
unnamed: D12.K, D13.A
unnamed: R1.2, R2.1, U$1.ADC0
unnamed: D2.A, U$1.DIO3 (TX1)
unnamed: D1.A, U$1.DIO2 (RX1)
unnamed: PV4.1 (+PV), R1.1, U$1.AUX (ALT)
OG: D12.A, U$1.22MA@ADC1 (CS1_22MA)
OG-WHT: D15.K, U$1.0V@ADC2 (0V)
