epccs/Irrigate7/SelfTest/Setup/SelfTestWiring.sch

## EAGLE design SelfTest/Setup/SelfTestWiring.sch (2018-11-14)

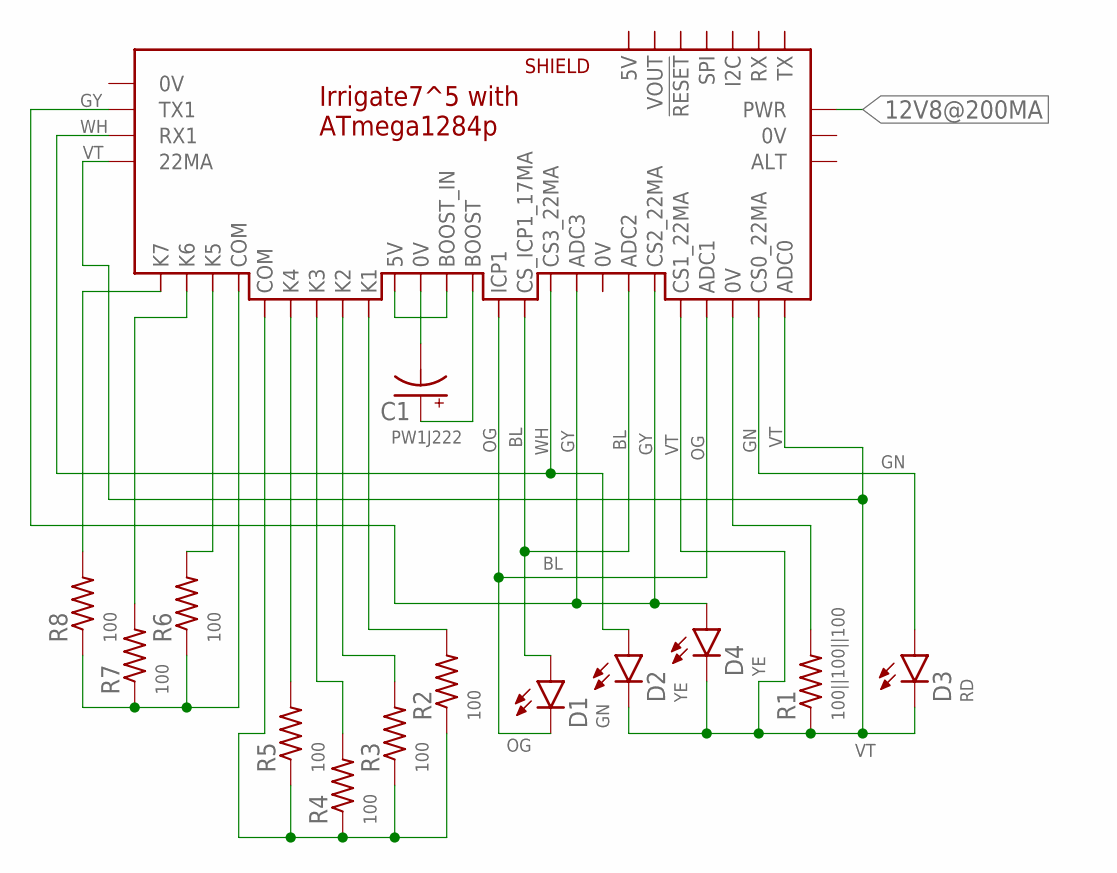
[picture p44: schematic SelfTestWiring.sch]

Parts:
C1: PW1J222; E7,5-18
D1: GN; LED5MM
D2, D4: YE; LED5MM
D3: RD; LED5MM
R1: 100||100||100; C0805(2012)
R2, R3, R4, R5, R6, R7, R8: 100; C0805(2012)
U$2: IRRIGATE7; WITH_RPU_NAMES

Connections:
12V8@200MA: U$2.PWR
BL: D1.A, U$2.17MA@ICP1 (CS_ICP1_17MA), U$2.ADC4 (ADC2)
GN: D3.A, U$2.22MA@ADC0 (CS0_22MA)
GY: D4.A, U$2.22MA@ADC4 (CS2_22MA), U$2.ADC5 (ADC3), U$2.DIO3 (TX1)
unnamed: U$2.5V, U$2.BOOST_IN
unnamed: R2.2, U$2.K1
unnamed: R2.1, R3.1, R4.1, R5.1, U$2.COM@K4 (COM)
unnamed: R1.2, U$2.0V@ADC2 (0V)
unnamed: R5.2, U$2.K4
unnamed: R4.2, U$2.K3
unnamed: R3.2, U$2.K2
unnamed: R6.2, U$2.K5
unnamed: R6.1, R7.1, R8.1, U$2.COM@K5 (COM)
unnamed: C1.-, U$2.0V
unnamed: C1.+, U$2.BOOST
unnamed: R7.2, U$2.K6
unnamed: R8.2, U$2.K7
OG: D1.K, U$2.ADC1, U$2.ICP1
VT: D2.K, D3.K, D4.K, R1.1, U$2.22MA@ADC1 (CS1_22MA), U$2.22MA@DIO2 (22MA), U$2.ADC0
WH: D2.A, U$2.22MA@ADC5 (CS3_22MA), U$2.DIO2 (RX1)
