epccs/Irrigate7/Solenoid/Setup/SolenoidWiring.sch

## EAGLE design Solenoid/Setup/SolenoidWiring.sch (2018-12-20)

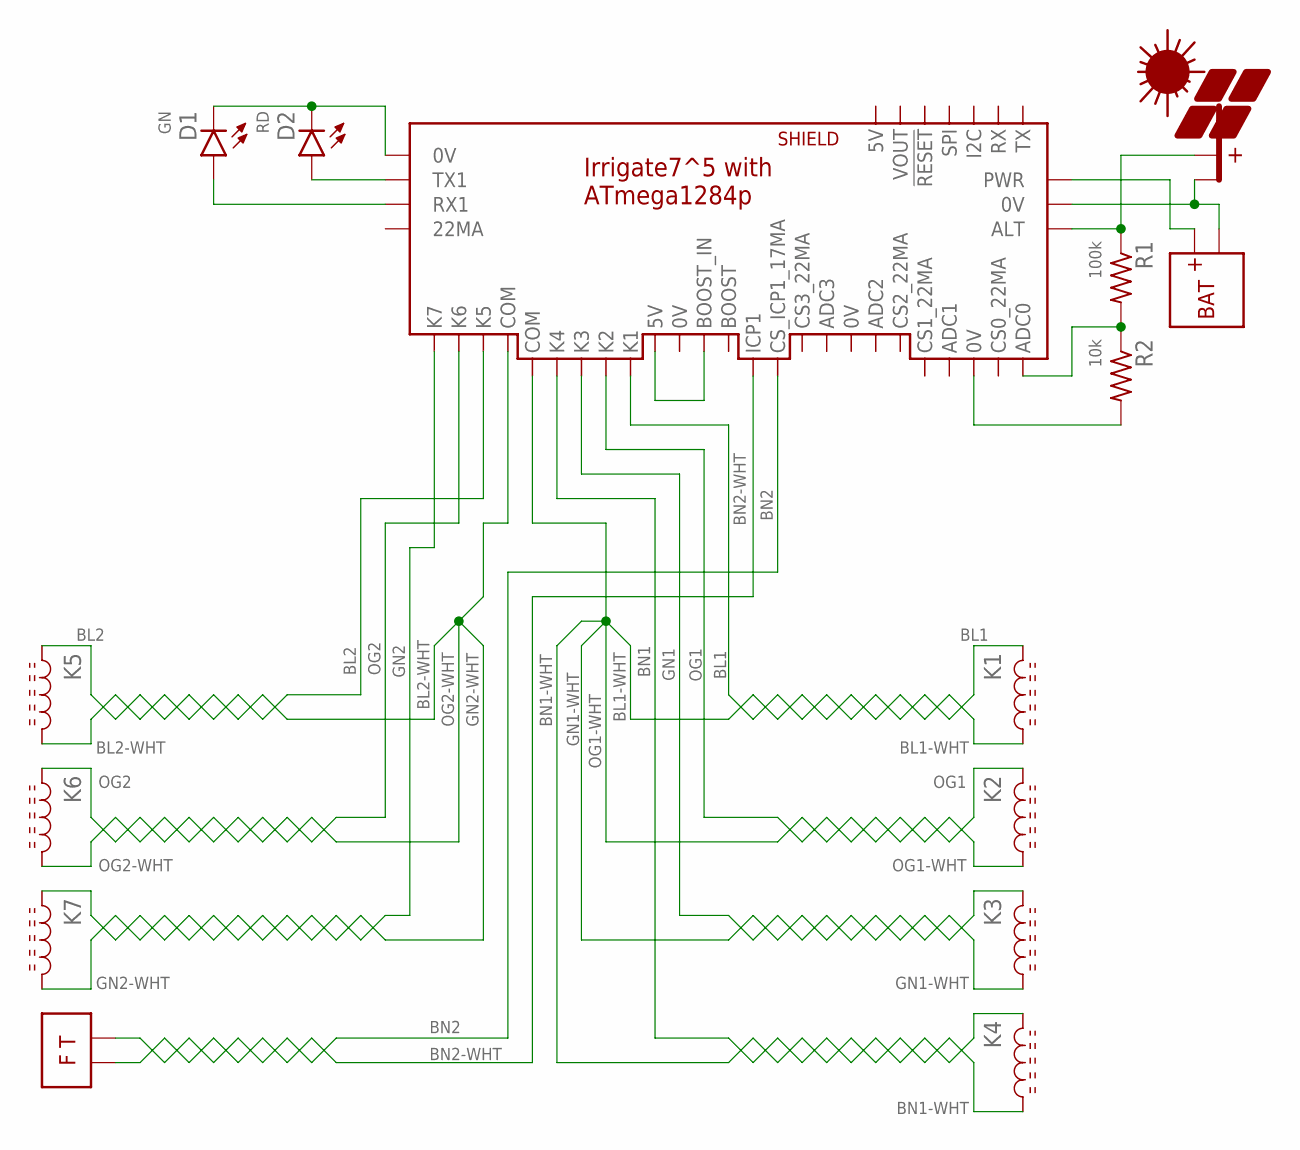
[picture p45: schematic SolenoidWiring.sch]

Parts:
D1: GN; LED5MM
D2: RD; LED5MM
K1, K2, K3, K4, K5, K6, K7: L0805; C0805(2012)
PV4: PV; NA-30
R1: 100k; C0805(2012)
R2: 10k; C0805(2012)
U$1: IRRIGATE7; WITH_RPU_NAMES
U$3: FT; NA-30
U$7: BAT; NA-30

Connections:
0V: PV4.2 (-PV), U$1.0V@PWR (0V), U$7.2 (-BAT)
BL1: K1.1, U$1.K1
BL1-WHT: K1.2
BL2: K5.1, U$1.K5
BL2-WHT: K5.2
BN1: K4.1, U$1.K4
BN1-WHT: K4.2
BN2: U$1.17MA@ICP1 (CS_ICP1_17MA), U$3.2 (PWR)
BN2-WHT: U$1.ICP1, U$3.1 (PL)
GN1: K3.1, U$1.K3
GN1-WHT: K3.2
GN2: K7.1, U$1.K7
GN2-WHT: K7.2
unnamed: U$1.PWR, U$7.1 (+BAT)
unnamed: R2.2, U$1.0V@ADC2 (0V)
unnamed: D1.K, D2.K, U$1.17MA@ICP3 (0V)
unnamed: R1.2, R2.1, U$1.ADC0
unnamed: U$1.5V, U$1.BOOST_IN
unnamed: D2.A, U$1.DIO3 (TX1)
unnamed: D1.A, U$1.DIO2 (RX1)
unnamed: PV4.1 (+PV), R1.1, U$1.AUX (ALT)
OG1: K2.1, U$1.K2
OG1-WHT: K2.2
OG2: K6.1, U$1.K6
OG2-WHT: K6.2
