epccs/Irrigate7/(commit log)

2015-06-06 readme links to board web page
2016-06-08 Bootloader: try xboot, optiboot may not be broken found serial problem.
    [main.c]
2016-06-08 BlinkLED: disable safemode fuse checking.
2016-06-09 Uart: copy from RPUno with changes for atmega1284p
2016-07-26 Adc: from RPUno with mods for Irrigate7's MCU and board setup
2016-08-02 CCtest: fix adc and step down the discharge voltage
    to see data for Amp-Time
    [main.c]
2016-08-09 LoopPwr: initial try of sensor loop select
    also backport some updates to CCtest from RPUno
2016-11-15 Hardware: add schematic
2016-11-15 Hardware: schematic links
2017-04-15 Hardware: moving info from hg repo
    [14320,BOM.csv, MultiDrop.sch]
2017-04-23 Hardware: showing schematic but keep in mind it is wip
2017-04-24 Hardware: show schematic wip for ^2, layout starts soon
2017-05-09 Hardware: ^2 bom done
    [14320,BOM.csv]
2017-05-09 Hardware: digital curr sources 22mA
    parts shown were for 17mA, bom has them
2017-05-20 Hardware: charge and discharge low pass filter to avg curr sense
    [14320,BOM.csv]
2017-05-21 Hardware: crystal capacitors
    [14320,BOM.csv]
2017-06-07 Hardware: part for i2c conn
    [14320,BOM.csv]
2017-06-16 Adc: use references in eeprom like rpuno is doing
2017-06-21 SelfTest: adc and dio tested, dio protection resistor
    [14320,BOM.csv, SelfTestWiring.sch]
2017-06-27 Solenoid: port from RPUno, this is also used for testing
    [SelfTestWiring.sch, SolenoidTestWiring.sch]
2017-06-29 Hardware: ^3 move J9, pull up IO9, thru led
    [14320,BOM.csv]
2017-07-03 Hardware: ^3 on order
    [14320,BOM.csv]
2017-07-26 Hardware: ^3 has problem with via on some wires
    [14320,BOM.csv]
2017-07-30 Hrdware: ^4 order boards (note ^3 has a via in a bad place)
2018-01-29 Hardware: ^5 schematic, overhaul to remove LT3652
2018-09-01 Hardware: ^5 layout, bom is next
2018-09-04 Hardware: ^5 bom, review is next
    [14320,BOM.csv, 14320BRD,BOM.csv, 14320DIN,BOM.csv, 14320HDR,BOM.csv, 14320PLUG,BOM.csv, 14320SMD,BOM.csv]
2018-09-06 Hardware: ^5 reviewing multi-drop example
    [MultiDrop.sch]
2018-10-30 Hardware: ^5 assembly
    [14320SMD,BOM.csv]
2018-11-09 Hardware: ^5 testing, selftest is needed
    [14320HDR,BOM.csv, MultiDrop.sch]
2018-11-14 BlinkLED: updates for ^5
    [SelfTestWiring.sch]
2018-11-17 ADC: updates for ^5
    [KNLWiring.sch]
2018-11-29 Adc: checked for ^5
2018-11-30 Capture: ^5 update, use icp cs to test, remove pwm test.
2018-12-10 DayNight: ^5 updates
    [LightSensorWiring.sch]
2018-12-11 Eeprom: ^5 update
    [LightSensorWiring.sch]
2018-12-15 i2c-debug: for ^5
    [KNLWiring.sch]
2018-12-16 Alternat: for ^5
    [AuxilaryWiring.sch]
2018-12-18 Digital: allow status LED on TX1
2018-12-20 Solenoid: for ^5
    [SolenoidTestWiring.sch, SolenoidWiring.sch]
2018-12-23 NightLight: for ^5
    [NightLightWiring.sch]
2019-01-04 Uart: ^5 updates
2019-01-23 Hardware: evaluation with valves
