epccs/Irrigate7/(notices)

Notices in the files:
Digital/digital.c:
modify it under the terms of the GNU General Public License
SelfTest/main.c:
This Library is free software: you can redistribute it and/or modify
it under the terms of the GNU General Public License as published by
the Free Software Foundation, either version 3 of the License, or
(at your option) any later version.
parts and their libraries:
Documentation: Copyright (C) 2014 Ronald Steven Sutherland
Attribution Share-Alike 3.0 License
http://creativecommons.org/licenses/by-sa/3.0
D-LED: Copyright (C) 2013 Ronald Steven Sutherland
L-PWR: Copyright (C) 2015 Ronald Sutherland
